wbrxcorp/esp32-devboard/esp32-devboard-tft-shield/esp32-devboard-tft-shield.kicad_pcb

## KiCad design esp32-devboard-tft-shield/esp32-devboard-tft-shield.kicad_pcb (2019-03-22)

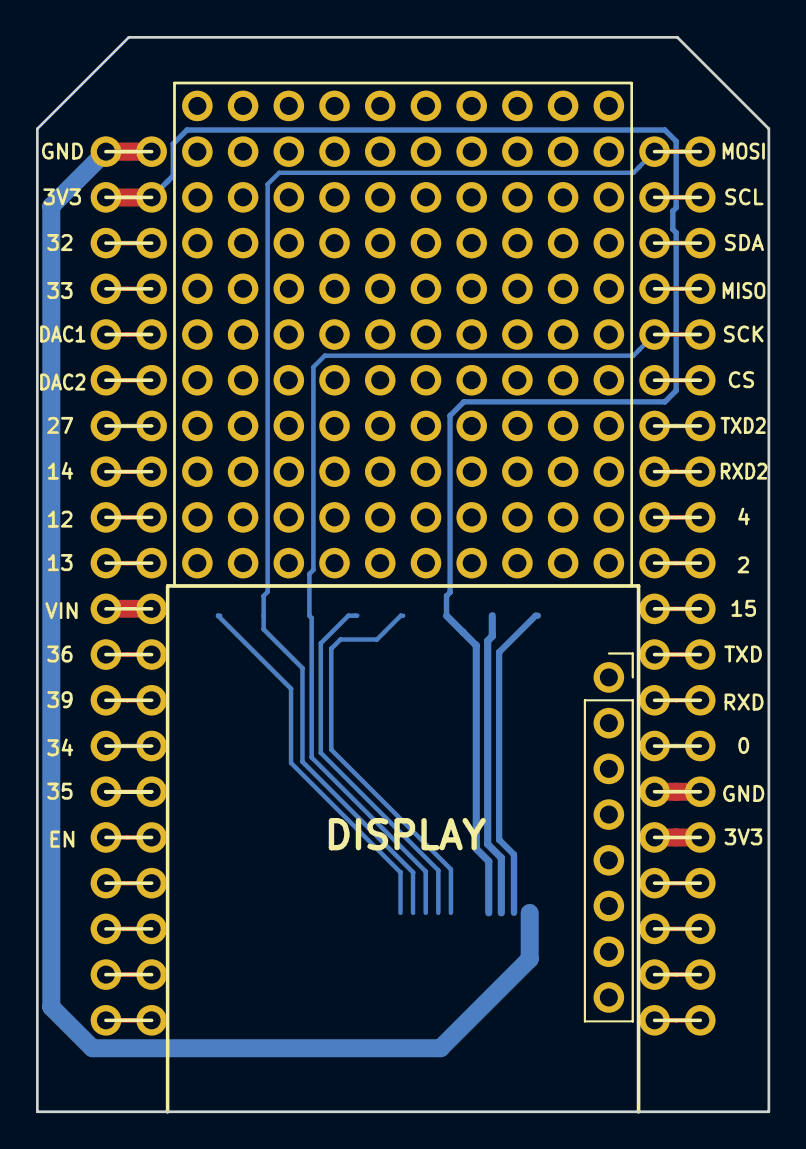
[picture p1: board esp32-devboard-tft-shield.kicad_pcb from above]

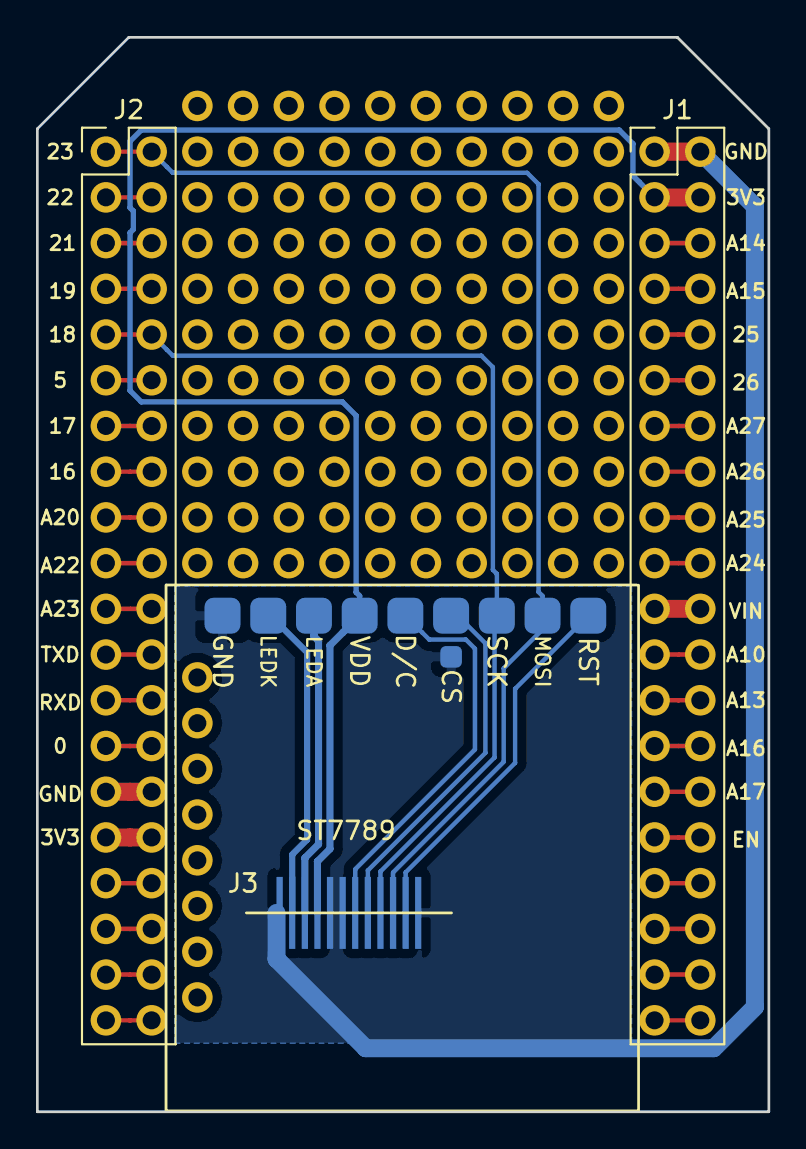
[picture p2: board esp32-devboard-tft-shield.kicad_pcb from below]

Board: 2 copper layers, 40.6 x 59.7 mm, 4 parts (3 on the bottom side), 40 nets.

Parts:
J1: Conn_02x20; PinHeader_2x20_P2.54mm_Vertical
J1#2: 11x10; Prototype_Area_2.54mm_11x10
J2: Conn_01x40; PinHeader_2x20_P2.54mm_Vertical
J3: Conn_01x12; TFT-12P

Connections:
/0: J2.27, J2.28
/2: J2.19, J2.20
/3V3: J1.3, J1.4, J3.4
/4: J2.17, J2.18
/12: J1.17, J1.18
/13: J1.19, J1.20
/14: J1.15, J1.16
/15: J2.21, J2.22
/27: J1.13, J1.14
/32: J1.5, J1.6
/33: J1.7, J1.8
/34: J1.27, J1.28
/35: J1.29, J1.30
/36: J1.23, J1.24
/39: J1.25, J1.26
/CS: J2.11, J2.12
/DAC1: J1.9, J1.10
/DAC2: J1.11, J1.12
/EN: J1.31, J1.32
/MISO: J2.7, J2.8
/MOSI: J2.1, J2.2, J3.10
/RXD: J2.25, J2.26
/RXD2: J2.15, J2.16
/SCK: J2.9, J2.10, J3.9
/SCL: J2.3, J2.4
/SDA: J2.5, J2.6
/TXD: J2.23, J2.24
/TXD2: J2.13, J2.14
/VIN: J1.21, J1.22
GND: J1.1, J1.2, J3.1, J3.5, J3.6, J3.12
unnamed: J1.33, J1.34
unnamed: J1.35, J1.36
unnamed: J1.37, J1.38
unnamed: J1.39, J1.40
unnamed: J2.29, J2.30
unnamed: J2.31, J2.32
unnamed: J2.33, J2.34
unnamed: J2.35, J2.36
unnamed: J2.37, J2.38
unnamed: J2.39, J2.40
