wbrxcorp/esp32-devboard/esp32-devboard/esp32-devboard.kicad_pcb

## KiCad design esp32-devboard/esp32-devboard.kicad_pcb (2019-03-14)

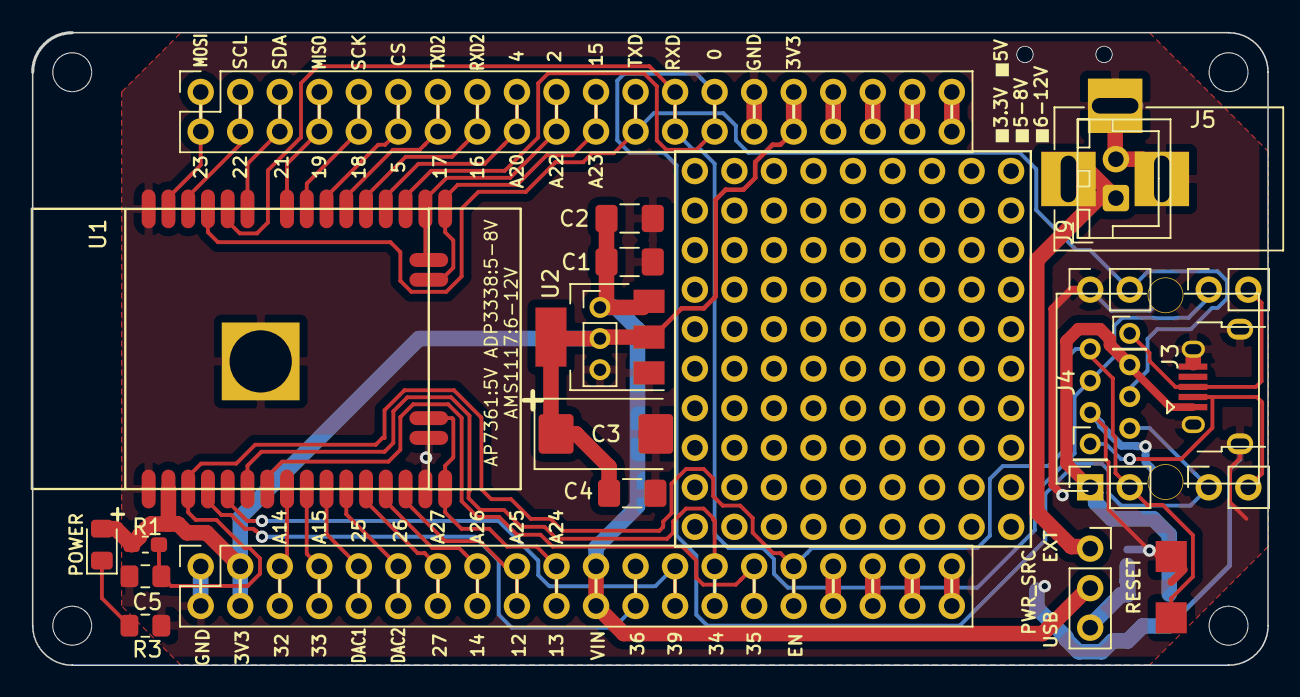
[picture p3: board esp32-devboard.kicad_pcb from above]

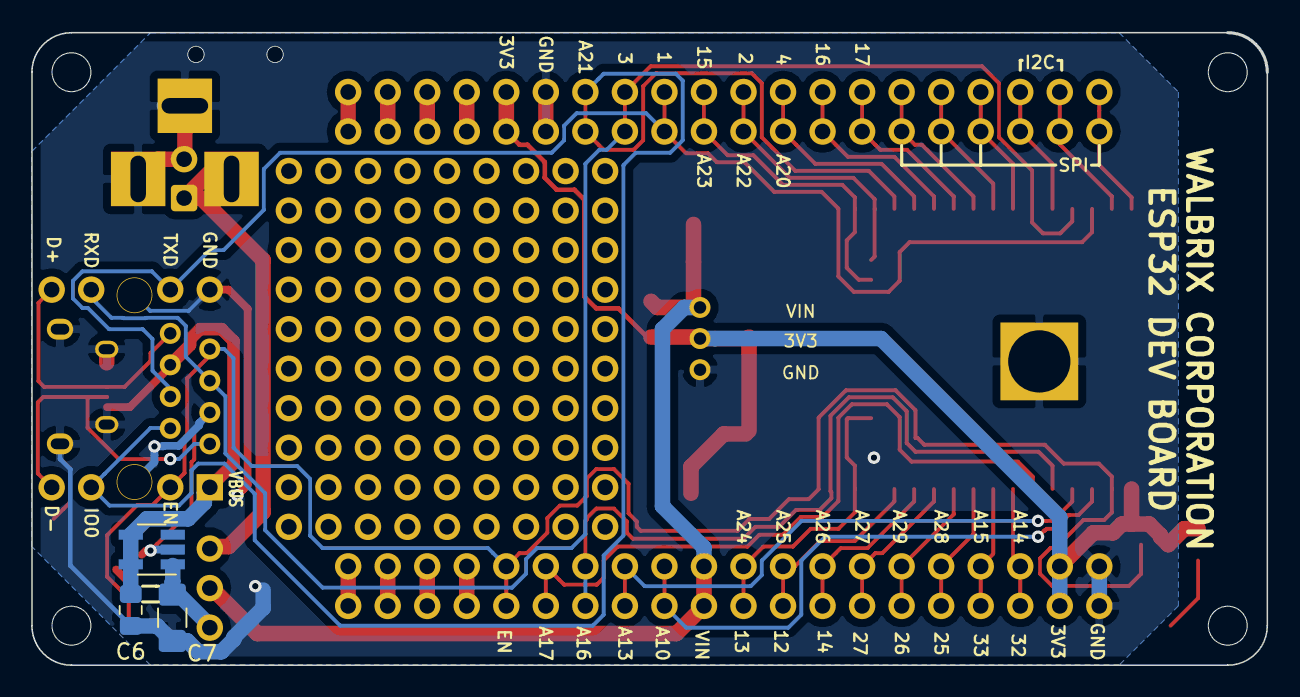
[picture p4: board esp32-devboard.kicad_pcb from below]

Board: 2 copper layers, 79.4 x 40.6 mm, 29 parts (3 on the bottom side), 44 nets.

Parts:
C1, C2, C4, C7: C; C_1206_3216Metric_Pad1.42x1.75mm_HandSolder
C3: C; CP_EIA-7343-15_Kemet-W_Pad2.25x2.55mm_HandSolder
C5: 1uF; C_0805_2012Metric_Pad1.15x1.40mm_HandSolder
C6: C; C_0805_2012Metric_Pad1.15x1.40mm_HandSolder
D1: LED; LED_0805_2012Metric_Pad1.15x1.40mm_HandSolder
J1, J2: Conn_01x40; PinSocket_2x20_P2.54mm_Vertical
J3: USB_B_Micro; USB_Micro-B_Horizontal
J4: RJ12
J5: Barrel_Jack_Switch; BARREL_JACK
J6, J7, J10, J11: Conn_01x02; PinSocket_1x02_P2.54mm_Vertical
J8: Conn_01x03; PinHeader_1x03_P2.00mm_Vertical
J9: Conn_01x02; JST_XH_B02B-XH-A_1x02_P2.50mm_Vertical
J12: TPS2065DBVR; SOT-23-5_HandSoldering
J13, J14: Conn_01x01; PinHeader_1x01_P2.00mm_Vertical
JX: 09x10; Prototype_Area_2.54mm_09x10
R1: 10K; R_0603_1608Metric_Pad1.05x0.95mm_HandSolder
R3: R; R_0805_2012Metric_Pad1.15x1.40mm_HandSolder
SW1: SW_Push; tactile_switch_smd_4x3mm_2p
SW2: SW_SPDT; PinSocket_1x03_P2.54mm_Vertical
U1: ESP32-WROOM-WROVER
U2: AMS1117-3.3; SOT-223-3_TabPin2

Connections:
/3V3: C3.1, C4.1, D1.2, J1.3, J1.4, J2.31, J2.32, J8.2, R1.1, U1.2, U2.2
/32: J1.5, J1.6, U1.8
/33: J1.7, J1.8, U1.9
/34: J1.27, J1.28, U1.6
/35: J1.29, J1.30, U1.7
/A0: J1.23, J1.24, U1.4
/A3: J1.25, J1.26, U1.5
/CS: J2.11, J2.12, U1.29
/D+: J3.3, J11.2, J13.1
/D-: J3.2, J10.2, J14.1
/DAC1: J1.9, J1.10, U1.10
/DAC2: J1.11, J1.12, U1.11
/EN: C5.1, J1.31, J1.32, J4.1, J6.2, R1.2, SW1.2, U1.3
/IO0: J2.27, J2.28, J4.6, J10.1, U1.25
/IO2: J2.19, J2.20, U1.24
/IO4: J2.17, J2.18, U1.26
/IO12: J1.17, J1.18, U1.14
/IO13: J1.19, J1.20, U1.16
/IO14: J1.15, J1.16, U1.13
/IO15: J2.21, J2.22, U1.23
/IO27: J1.13, J1.14, U1.12
/MISO: J2.7, J2.8, U1.31
/MOSI: J2.1, J2.2, U1.37
/RXD: J2.25, J2.26, J4.3, J11.1, U1.34
/RXD2: J2.15, J2.16, U1.27
/SCK: J2.9, J2.10, U1.30
/SCL: J2.3, J2.4, U1.36
/SDA: J2.5, J2.6, U1.33
/TXD: J2.23, J2.24, J4.4, J7.2, U1.35
/TXD2: J2.13, J2.14, U1.28
/USB_PWR: C7.1, J12.1, SW2.3
/VBUS: C6.1, J3.1, J4.2, J6.1, J12.4, J12.5
/VEXT: J5.1, J9.1, SW2.1
/VIN: C1.1, C2.1, J1.21, J1.22, J8.1, SW2.2, U2.3
GND: C1.2, C2.2, C3.2, C4.2, C5.2, C6.2, C7.2, J1.1, J1.2, J2.29, J2.30, J3.5, J3.6, J4.5, J5.2, J5.3, J7.1, J8.3, J9.2, J12.2, R3.2, SW1.1, U1.1, U1.15, U1.38, U1.39, U2.1
unnamed: D1.1, R3.1
unnamed: J1.33, J1.34
unnamed: J1.35, J1.36
unnamed: J1.37, J1.38
unnamed: J1.39, J1.40
unnamed: J2.33, J2.34
unnamed: J2.35, J2.36
unnamed: J2.37, J2.38
unnamed: J2.39, J2.40
