wbrxcorp/esp32-devboard/regulator/regulator.kicad_pcb

## KiCad design regulator/regulator.kicad_pcb (2019-03-07)

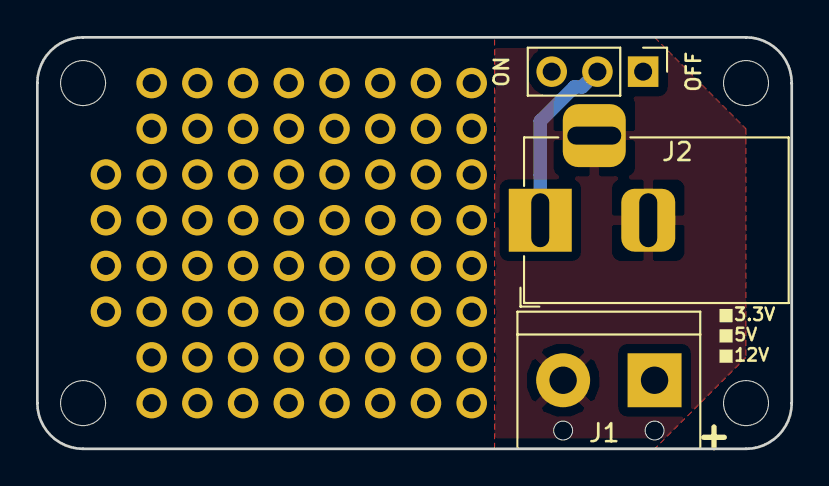
[picture p5: board regulator.kicad_pcb from above]

Board: 2 copper layers, 41.9 x 22.9 mm, 5 parts (0 on the bottom side), 2 nets.

Parts:
J1: 0x04; Prototype_Area_2.54mm_01x04
J1#2: Conn_01x02; TerminalBlock_bornier-2_P5.08mm
J2: Barrel_Jack_Switch; BarrelJack_Horizontal
J10: 09x10; Prototype_Area_2.54mm_08x08
SW1: SW_SPDT; PinHeader_1x03_P2.54mm_Vertical

Connections:
GND: J1#2.2, J2.2, J2.3
unnamed: J2.1, SW1.2
