wbrxcorp/esp32-devboard/usbesp-addon/usbesp-addon.kicad_pcb

## KiCad design usbesp-addon/usbesp-addon.kicad_pcb (2019-03-03)

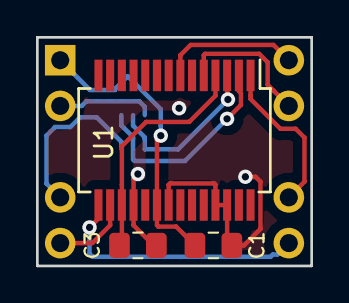
[picture p6: board usbesp-addon.kicad_pcb from above]

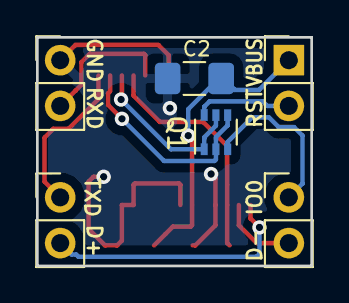
[picture p7: board usbesp-addon.kicad_pcb from below]

Board: 2 copper layers, 15.2 x 12.7 mm, 9 parts (6 on the bottom side), 11 nets.

Parts:
C1, C3: 0.1uF; C_0805_2012Metric_Pad1.15x1.40mm_HandSolder
C2: 10uF; C_1206_3216Metric_Pad1.42x1.75mm_HandSolder
J1, J2, J3, J4: Conn_01x02; PinHeader_1x02_P2.54mm_Vertical
Q1: BC847BS; SOT-363_SC-70-6
U1: FT232RL; SSOP-28_5.3x10.2mm_P0.65mm

Connections:
/3v3: C3.1, U1.4, U1.17
/DTR: Q1.2, Q1.4, U1.2
/IO0: J1.1, Q1.3
/RESET: J2.2, Q1.6
/RTS: Q1.1, Q1.5, U1.3
/RXD: J3.2, U1.5
/TXD: J4.1, U1.1
/USBDM: J1.2, U1.16
/USBDP: J4.2, U1.15
/VBUS: C1.1, C2.1, J2.1, U1.20
GND: C1.2, C2.2, C3.2, J3.1, U1.7, U1.18, U1.21, U1.25, U1.26
