wbrxcorp/esp32-devboard/usbesp-rj12/usbesp-rj12.kicad_pcb

## KiCad design usbesp-rj12/usbesp-rj12.kicad_pcb (2019-02-22)

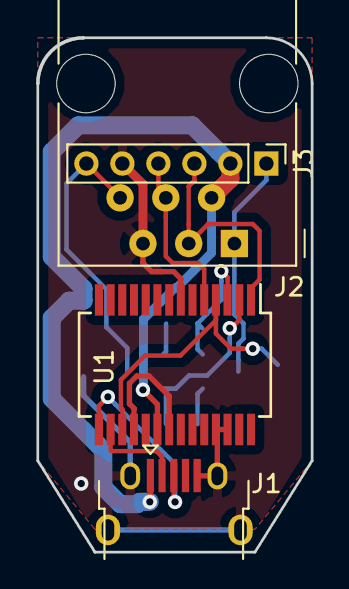
[picture p8: board usbesp-rj12.kicad_pcb from above]

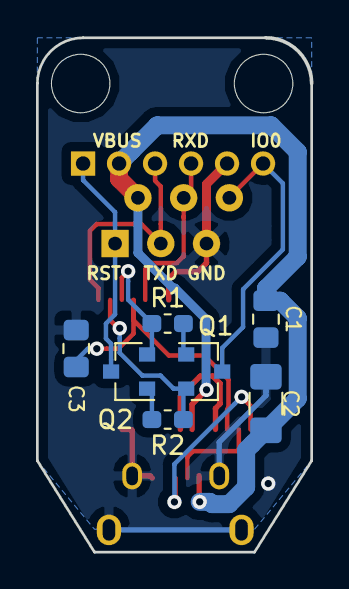
[picture p9: board usbesp-rj12.kicad_pcb from below]

Board: 2 copper layers, 15.2 x 28.6 mm, 11 parts (7 on the bottom side), 13 nets.

Parts:
C1, C3: 0.1uF; C_0805_2012Metric_Pad1.15x1.40mm_HandSolder
C2: 10uF; C_1206_3216Metric_Pad1.42x1.75mm_HandSolder
J1: USB_B_Micro; USB_Micro-B_Horizontal
J2: RJ12; RJ12_Amphenol_54601
J3: Conn_01x06; PinHeader_1x06_P2.00mm_Vertical
Q1, Q2: S9013; SOT-23
R1, R2: 10K; R_0603_1608Metric_Pad1.05x0.95mm_HandSolder
U1: FT232RL; SSOP-28_5.3x10.2mm_P0.65mm

Connections:
/3v3: C3.1, U1.4, U1.17
/DTR: Q1.2, R2.1, U1.2
/IO0: J2.6, J3.6, Q1.3
/RESET: J2.1, J3.1, Q2.3
/RTS: Q2.2, R1.1, U1.3
/RXD: J2.4, J3.4, U1.5
/TXD: J2.3, J3.3, U1.1
/USBDM: J1.2, U1.16
/USBDP: J1.3, U1.15
/VBUS: C1.1, C2.1, J1.1, J2.2, J3.2, U1.20
GND: C1.2, C2.2, C3.2, J1.5, J1.6, J2.5, J3.5, U1.7, U1.18, U1.21, U1.25, U1.26
unnamed: Q1.1, R1.2
unnamed: Q2.1, R2.2
