wbrxcorp/esp32-devboard/(commit log)

2019-02-11 begin with 3 boards
    [esp32-devboard-prototype-shield.kicad_pcb, esp32-devboard-prototype-shield.sch, esp32-devboard.kicad_pcb, esp32-devboard.sch, usbesp-addon.kicad_pcb, usbesp-addon.sch]
2019-02-22 usbesp-rj12 moved from other project
    [esp32-devboard.kicad_pcb, esp32-devboard.sch, usbesp-rj12.kicad_pcb, usbesp-rj12.sch]
2019-03-03 PCB update
    [esp32-devboard.kicad_pcb, esp32-devboard.sch, usbesp-addon.kicad_pcb, usbesp-addon.sch]
2019-03-03 Quarter shield added
    [esp32-devboard-prototype-shield-q.kicad_pcb, esp32-devboard-prototype-shield-q.sch]
2019-03-04 regulator board added
    [regulator.kicad_pcb, regulator.sch]
2019-03-05 change pinouts
    [esp32-devboard.kicad_pcb, esp32-devboard.sch]
2019-03-05 prototype area enlarged
    [regulator.kicad_pcb]
2019-03-05 follow pinout changes
    [esp32-devboard-prototype-shield-q.kicad_pcb]
2019-03-06 add 3v3 pin for external device
    [esp32-devboard.kicad_pcb, esp32-devboard.sch]
2019-03-06 regulator update
    [regulator.kicad_pcb, regulator.sch]
2019-03-06 add/enlarge holes
    [esp32-devboard.kicad_pcb, regulator.kicad_pcb]
2019-03-09 add ST7789(no cs pin) driver (incomplete)
2019-03-14 ESP32-WROVER support
    [esp32-devboard.kicad_pcb]
2019-03-20 TFT shield added
    [esp32-devboard-tft-shield.kicad_pcb, esp32-devboard-tft-shield.sch]
2019-03-20 ammeter added
    [ammeter.kicad_pcb, ammeter.sch]
2019-03-20 fix socket location
    [esp32-devboard-tft-shield.kicad_pcb]
2019-03-22 tft shield update
    [esp32-devboard-tft-shield.kicad_pcb, esp32-devboard-tft-shield.sch]
